IOGS-LEnsE-platforms/machine-vision/README.md

# Machine Vision Platform
Documentation of the pedagogic platform about Machine Vision used during labwors @ LEnsE / IOGS / France

Watch the complete documentation [here !!!](https://iogs-lense.github.io/machine-vision/)

## About Institut d'Optique and LEnsE
The **LEnsE**, ***Laboratoire d'Enseignement Expérimental***, [Website](http://lense.institutoptique.fr/)
