IOGS-LEnsE-platforms/machine-vision/docs/source/index.rst

.. Machine-Vision platform documentation master file, created by
   sphinx-quickstart on Sat Jan 13.
   You can adapt this file completely to your liking, but it should at least contain the root `toctree` directive.

Machine Vision platform's documentation
#######################################

.. caution::
   This documentation website is still in development

**Machine Vision** GitHub repository contains documentations of the pedagogic technical platform developed for Machine Vision labworks and projects of students.

The GitHub repository of this project : `Machine Vision <https://github.com/IOGS-LEnsE-platforms/machine-vision>`_

|

.. toctree::
   :maxdepth: 1
   :caption: Machine Vision
   
	Machine Vision platform<contents/machine_vision>

.. toctree::
   :maxdepth: 1
   :caption: Materials

	Overview<contents/material_overview>
	Electronic board<contents/material_board>
	Testing procedure<contents/material_testing>

.. toctree::
   :maxdepth: 1
   :caption: How To

.. toctree::
   :maxdepth: 1
   :caption: Contributors
   
	Main contributors<contents/main_contributors>
	Students contributions<contents/other_contributors>

Ressources
**********

Projects based on this platform require the following ressources :

* `Camera Interfaces <https://iogs-lense-ressources.github.io/camera-gui/>`_ to integrate camera vision for image processing.

Trainings
*********

Projects based on this platform require the following trainings :

* **Nucleo board basics** to control the conveyor, the lighting system, the sorter system and to get data from presence sensors for exemple.
* **Python GUI basics** to create a graphical user interface.
* **Python communication** to transmit data to a microcontroller (that controls the hardware part of the platform : conveyor, lights, sorter, sensors...).

About the LEnsE
***************

The **Experimental Teaching Laboratory** (*LEnsE*, for *Laboratoire d’ENSeignement Expérimental*) is a major structure of the *Institut d'Optique* engineering school. It offers remarkably strong training that contributes 25% of the total curriculum. It is an impressive structure where students have access to a large diversity of material and human resources to be able to gain the skills to become excellent experimenters recognized in their field.
