IOGS-LEnsE-platforms/machine-vision/documentation/brochages.pptx

Computer Vision / L476 board

Control of computer vision bench / Dobot conveyor

Functions

- Step Motor Control (x2)
  - Step Motor Driver – TMC2100
- RF data transmission
  - RN41/42 – Evaluation Board XV
- Position sensor SEN0239 (x3)
- Light control (x3 – R / G / B)

PROJECT VERSION

Based on Nucleo L476RG board

## Slide 2

Computer Vision / L476 board

Control of computer vision bench / Dobot conveyor

TX

PC_10

PC_12

Morpho Gauche / Nucléo

PC_11

PD_2

E5V

GPIO2_STATUS

RX

POUSS. 3

PC_9

PB_8

PB_9

Morpho Droit / Nucléo

PC_8

PC_6

PC_5

POUSS. 2

POUSS. 1

PA_13

GND

nRF24 / SCK

AVDD

GND

PA_5 / SCK

U5V

PA_12

PA_14

PA_15

5V

3.3V

nRF24 / MOSI

nRF24 / MISO

PA_6 / MISO

PA_7 / MOSI

D10 / CS

PA_11

PB_12

PB_11

LED 1

LED 2

RESET_N

GND

PB_7

PC_13

Vin

PA_0

GND

GND

nRF24 / CSN

nRF24 / CE

nRF24 / IRQ

PC_7

PA_9

PA_8

GND

PB_1

PB_2

MOT1_CFG3

CAPT 1

CAPT 2

PC_14

PC_15

MOT2_EN

MOT2_DIR

MOT2_STEP

PB_10

PB_4

PB_5

PB_13

PB_15

PB_14

MOT1_CFG2

MOT1_CFG1

MOT1_EN

Not Used

Digital Output

Digital Input

Analog Input

CAPT 3

ECLAIR 3

PH_0

PH_1

PC_2

A2

PA_1

PB_0

V_OUT_REF

MOT1_STEP

MOT1_DIR

D1

PA_10

PB_3

PC_4

AGND

MOT1_STEP*

ECLAIR 2

ECLAIR 1

Analog Output

PC_3

PC_0

PC_1

D0

* Must be set as input

## Slide 3

TMC2100 – Step Motor Driver

Step Motor Driver / Motor 1 / TMC2100

MBED6 Library : https://github.com/IOGS-LEnsE-embedded/MBED6_SupOpLibraries/tree/main/TMC2100

Nucleo Board

Not Used

Digital Output

Digital Input

Analog Input

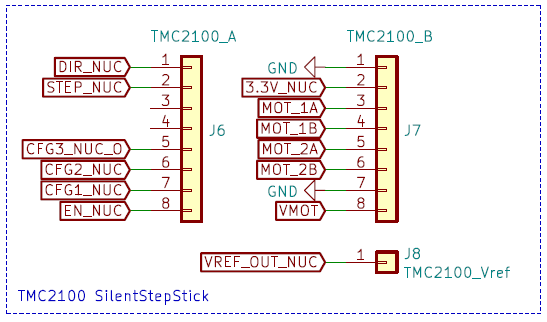
[picture p2: figure]

GND

TMC2100 / Motor1

PA_10

PB_3

MOT1_DIR

MOT1_STEP

3.3V

PB_1

MOT1_CFG3

PB_13

PB_15

PB_14

MOT1_CFG2

MOT1_CFG1

MOT1_EN

PC_4

PWM

MOT1_STEP

A2

V_OUT_REF

Analog Output

## Slide 4

nRF24 – RF transmission

nrF24L01 module for RF data transmission

MBED6 Library : https://github.com/IOGS-LEnsE-embedded/MBED6_SupOpLibraries/tree/main/nRF24

Nucleo Board

Not Used

Digital Output

Digital Input

Analog Input

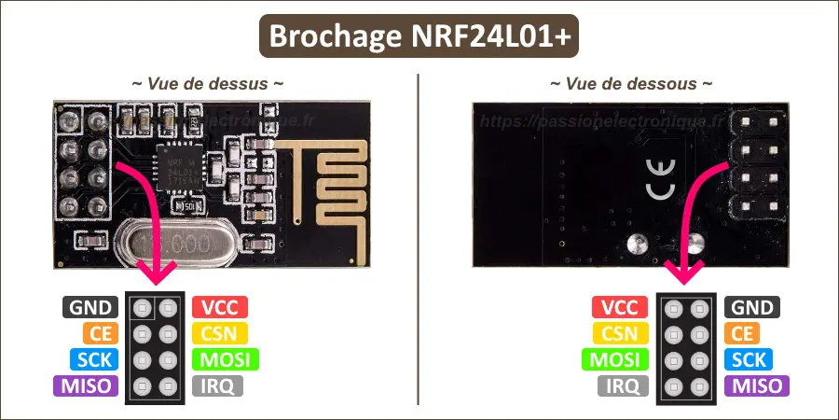
[picture p3: figure]

3.3V

GND

nRF24L01 / RF

PA_9

PA_8

PC_7

IRQ

CE

CSN

PA_6 / MISO

PA_7 / MOSI

PA_5/ SCK

SPI

MISO

MOSI

CLK

Analog Output
