IOGS-LEnsE-platforms/machine-vision/docs/source/contents/material_testing.rst

Machine Vision Testing procedures
#################################

Power supplies
**************

Lighting system
***************

Conveyor system
***************

Image acquisition
*****************
