IOGS-LEnsE-platforms/machine-vision/documentation/brochages.pdf

# Computer Vision / L476 board

# Control of computer vision bench / Dobot conveyor

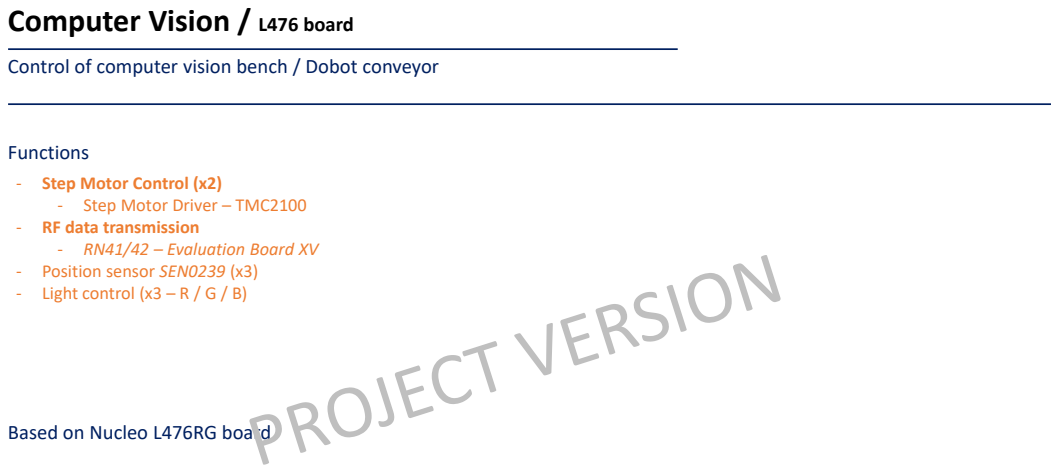
[picture p42: page 1]
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

Based on Nucleo L476RG board

# Computer Vision / L476 board

# Control of computer vision bench / Dobot conveyor

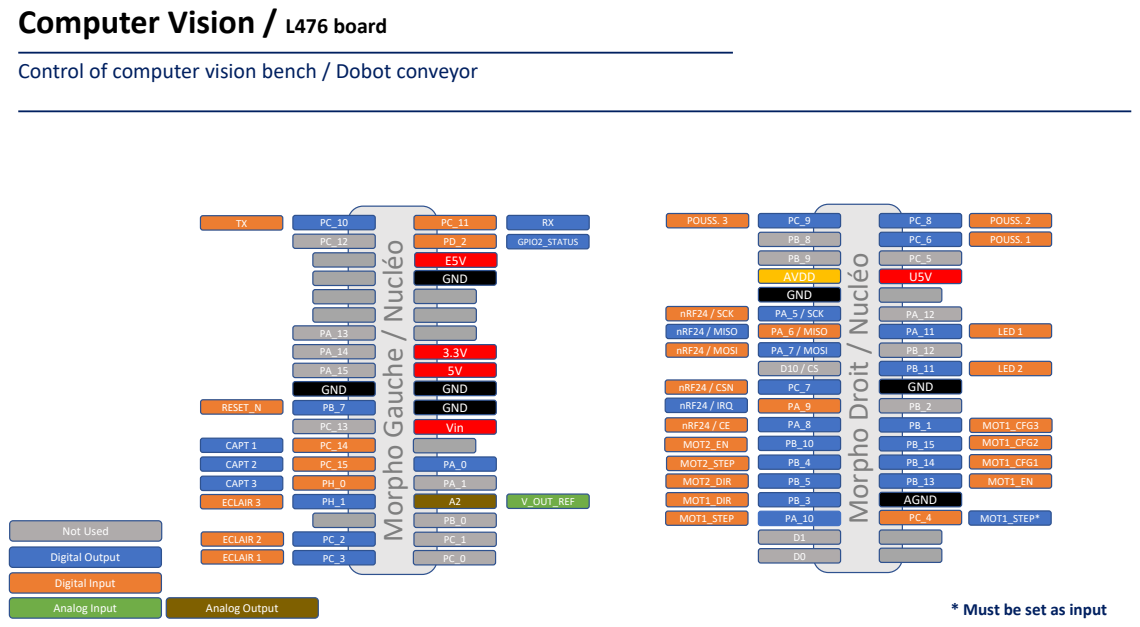
[picture p43: page 2]
Digital Output; Digital Input; Analog Input; PA_6 / MISO; PA_7 / MOSI; PA_5 / SCK; GND; AGND; AVDD; PD_2 E5V GND; GND Vin; RESET_N; GPIO2_STATUS; nRF24 / SCK; nRF24 / MISO; nRF24 / MOSI; nRF24 / IRQ; nRF24 / CSN; nRF24 / CE; Not Used; CAPT 1; CAPT 2; CAPT 3; ECLAIR 3; ECLAIR 2; ECLAIR 1; Analog Output; V_OUT_REF; POUSS. 3; POUSS. 2; POUSS. 1; LED 1; LED 2; MOT1_STEP; MOT1_DIR; MOT1_EN; MOT1_CFG1; MOT1_CFG2; MOT1_CFG3; MOT2_DIR; MOT2_STEP; MOT2_EN; MOT1_STEP*

Morpho Gauche / Nucléo

Morpho Droit / Nucléo

* Must be set as input

# TMC2100 – Step Motor Driver

# Step Motor Driver / Motor 1 / TMC2100 TMC2100 / Motor1

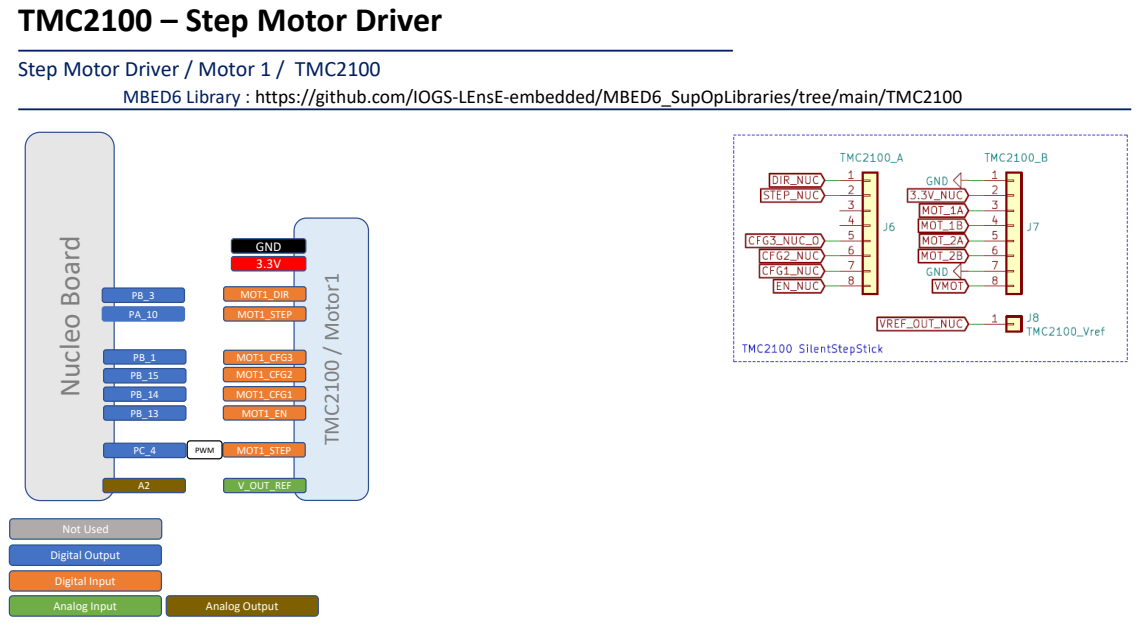
[picture p44: page 3]
Nucleo Board; GND 3.3V; MOT1_STEP; MOT1_DIR; MOT1_EN; MOT1_CFG1; MOT1_CFG2; MOT1_CFG3; PWM; V_OUT_REF; Digital Output; Digital Input; Not Used

MBED6 Library : https://github.com/IOGS-LEnsE-embedded/MBED6_SupOpLibraries/tree/main/TMC2100

# nRF24 – RF transmission

# nrF24L01 module for RF data transmission

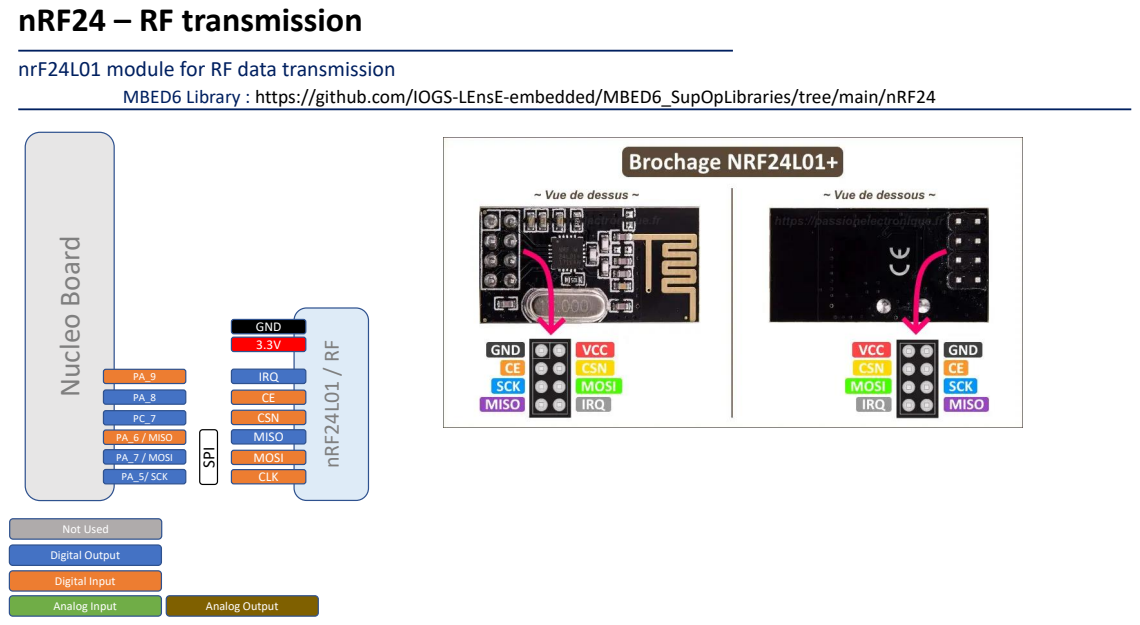
[picture p45: page 4]
Nucleo Board; PA_5/ SCK; nRF24L01 / RF; CLK; PA_7 / MOSI; MOSI; PA_6 / MISO; MISO SPI; CSN; IRQ; GND 3.3V; Digital Output; Digital Input; Not Used

MBED6 Library : https://github.com/IOGS-LEnsE-embedded/MBED6_SupOpLibraries/tree/main/nRF24
