IOGS-LEnsE-platforms/machine-vision/documentation/schematic.pdf

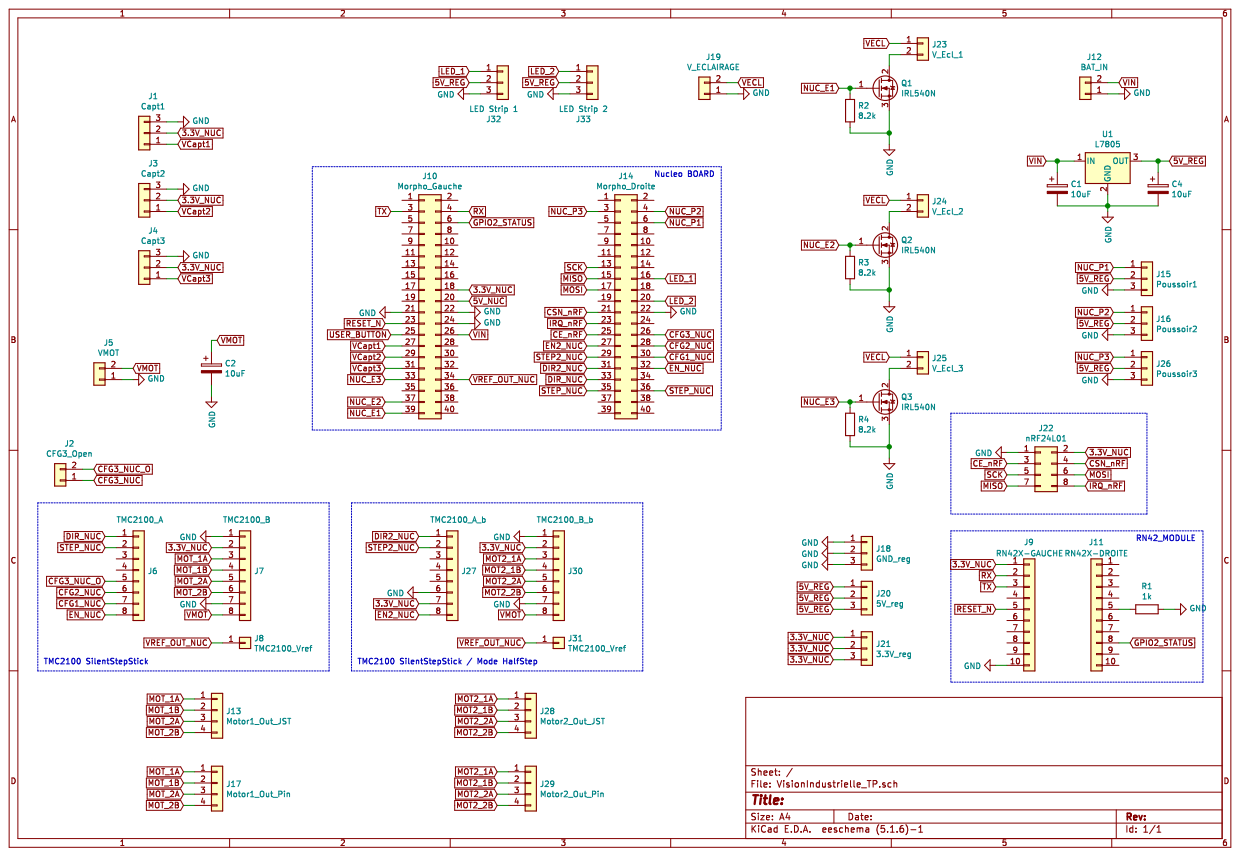
[picture p46: page 1]
