IOGS-LEnsE-platforms/machine-vision/documentation/PCB.pdf

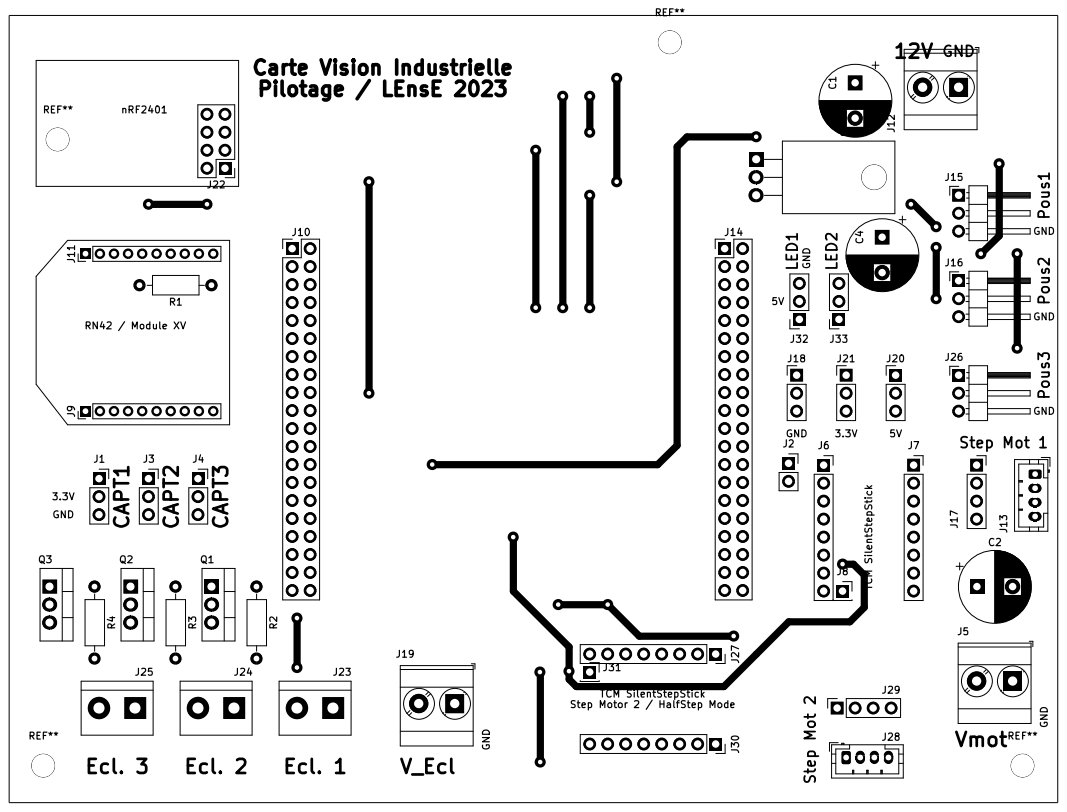
[picture p47: page 1]
