IOGS-LEnsE-platforms/machine-vision/elec_board/VisionIndustrielle_TP.kicad_pcb

## KiCad design elec_board/VisionIndustrielle_TP.kicad_pcb (2024-03-06)

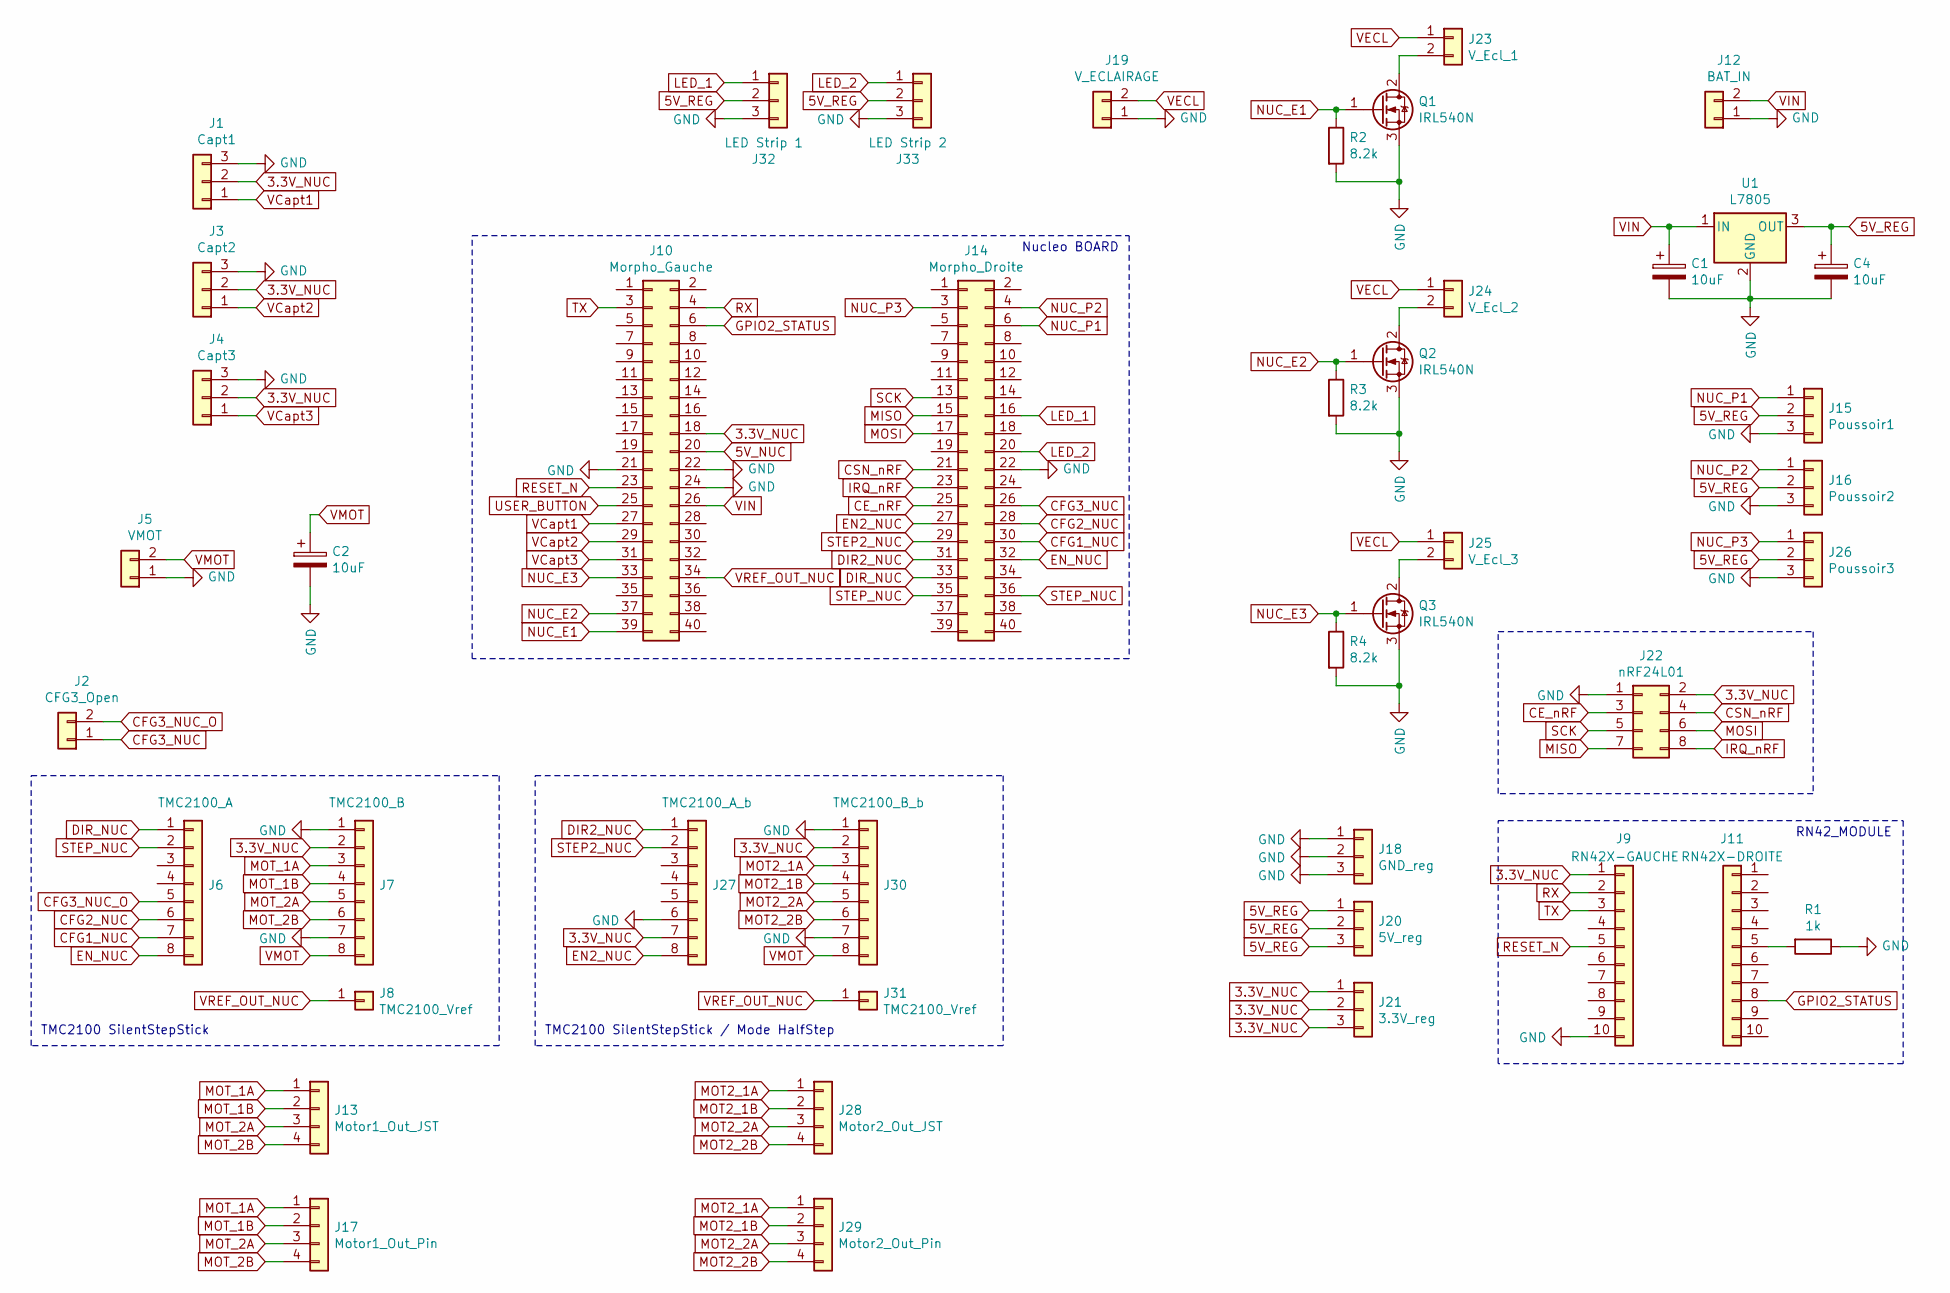
[picture p48: schematic VisionIndustrielle_TP.sch]

Parts:
C1, C2, C4: 10uF; CP_Radial_D10.0mm_P5.00mm
J1: Capt1; PinSocket_1x03_P2.54mm_Vertical
J2: CFG3_Open; PinSocket_1x02_P2.54mm_Vertical
J3: Capt2; PinSocket_1x03_P2.54mm_Vertical
J4: Capt3; PinSocket_1x03_P2.54mm_Vertical
J5: VMOT; TerminalBlock_Phoenix_MKDS-3-2-5.08_1x02_P5.08mm_Horizontal
J6: TMC2100_A; PinSocket_1x08_P2.54mm_Vertical
J7: TMC2100_B; PinSocket_1x08_P2.54mm_Vertical
J8, J31: TMC2100_Vref; PinSocket_1x01_P2.54mm_Vertical
J9: RN42X-GAUCHE; PinHeader_1x10_P2.00mm_Vertical
J10: Morpho_Gauche; PinHeader_2x20_P2.54mm_Vertical
J11: RN42X-DROITE; PinHeader_1x10_P2.00mm_Vertical
J12: BAT_IN; TerminalBlock_Phoenix_MKDS-3-2-5.08_1x02_P5.08mm_Horizontal
J13: Motor1_Out_JST; JST_PH_B4B-PH-K_1x04_P2.00mm_Vertical
J14: Morpho_Droite; PinHeader_2x20_P2.54mm_Vertical
J15: Poussoir1; PinHeader_1x03_P2.54mm_Horizontal
J16: Poussoir2; PinHeader_1x03_P2.54mm_Horizontal
J17: Motor1_Out_Pin; PinSocket_1x04_P2.54mm_Vertical
J18: GND_reg; PinHeader_1x03_P2.54mm_Vertical
J19: V_ECLAIRAGE; TerminalBlock_Phoenix_MKDS-3-2-5.08_1x02_P5.08mm_Horizontal
J20: 5V_reg; PinHeader_1x03_P2.54mm_Vertical
J21: 3.3V_reg; PinHeader_1x03_P2.54mm_Vertical
J22: nRF24L01; PinHeader_2x04_P2.54mm_Vertical
J23: V_Ecl_1; TerminalBlock_bornier-2_P5.08mm
J24: V_Ecl_2; TerminalBlock_bornier-2_P5.08mm
J25: V_Ecl_3; TerminalBlock_bornier-2_P5.08mm
J26: Poussoir3; PinHeader_1x03_P2.54mm_Horizontal
J27: TMC2100_A_b; PinSocket_1x08_P2.54mm_Vertical
J28: Motor2_Out_JST; JST_PH_B4B-PH-K_1x04_P2.00mm_Vertical
J29: Motor2_Out_Pin; PinSocket_1x04_P2.54mm_Vertical
J30: TMC2100_B_b; PinSocket_1x08_P2.54mm_Vertical
J32: LED Strip 1; PinSocket_1x03_P2.54mm_Vertical
J33: LED Strip 2; PinSocket_1x03_P2.54mm_Vertical
Q1, Q2, Q3: IRL540N; TO-220-3_Vertical
R1: 1k; R_Axial_DIN0207_L6.3mm_D2.5mm_P10.16mm_Horizontal
R2, R3, R4: 8.2k; R_Axial_DIN0207_L6.3mm_D2.5mm_P10.16mm_Horizontal
U1: L7805; TO-220-3_Horizontal_TabDown

Connections:
3.3V_NUC: J1.2, J3.2, J4.2, J7.2, J9.1, J10.18, J21.1, J21.2, J21.3, J22.2, J27.7, J30.2
5V_NUC: J10.20
5V_REG: C4.1, J15.2, J16.2, J20.1, J20.2, J20.3, J26.2, J32.2, J33.2, U1.3 (OUT)
CE_nRF: J14.25, J22.3
CFG1_NUC: J6.7, J14.30
CFG2_NUC: J6.6, J14.28
CFG3_NUC: J2.1, J14.26
CFG3_NUC_O: J2.2, J6.5
CSN_nRF: J14.21, J22.4
DIR2_NUC: J14.31, J27.1
DIR_NUC: J6.1, J14.33
EN2_NUC: J14.27, J27.8
EN_NUC: J6.8, J14.32
GND: C1.2, C2.2, C4.2, J1.3, J3.3, J4.3, J5.1, J7.1, J7.7, J9.10, J10.21, J10.22, J10.24, J12.1, J14.22, J15.3, J16.3, J18.1, J18.2, J18.3, J19.1, J22.1, J26.3, J27.6, J30.1, J30.7, J32.3, J33.3, Q1.3 (S), Q2.3 (S), Q3.3 (S), R1.1, R2.2, R3.2, R4.2, U1.2 (GND)
GPIO2_STATUS: J10.6, J11.8
IRQ_nRF: J14.23, J22.8
LED_1: J14.16, J32.1
LED_2: J14.20, J33.1
MISO: J14.15, J22.7
MOSI: J14.17, J22.6
MOT2_1A: J28.1, J29.1, J30.3
MOT2_1B: J28.2, J29.2, J30.4
MOT2_2A: J28.3, J29.3, J30.5
MOT2_2B: J28.4, J29.4, J30.6
MOT_1A: J7.3, J13.1, J17.1
MOT_1B: J7.4, J13.2, J17.2
MOT_2A: J7.5, J13.3, J17.3
MOT_2B: J7.6, J13.4, J17.4
NUC_E1: J10.39, Q1.1 (G), R2.1
NUC_E2: J10.37, Q2.1 (G), R3.1
NUC_E3: J10.33, Q3.1 (G), R4.1
NUC_P1: J14.6, J15.1
NUC_P2: J14.4, J16.1
NUC_P3: J14.3, J26.1
unnamed: J11.5, R1.2
unnamed: J23.2, Q1.2 (D)
unnamed: J24.2, Q2.2 (D)
unnamed: J25.2, Q3.2 (D)
RESET_N: J9.5, J10.23
RX: J9.2, J10.4
SCK: J14.13, J22.5
STEP2_NUC: J14.29, J27.2
STEP_NUC: J6.2, J14.35, J14.36
TX: J9.3, J10.3
USER_BUTTON: J10.25
VCapt1: J1.1, J10.27
VCapt2: J3.1, J10.29
VCapt3: J4.1, J10.31
VECL: J19.2, J23.1, J24.1, J25.1
VIN: C1.1, J10.26, J12.2, U1.1 (IN)
VMOT: C2.1, J5.2, J7.8, J30.8
VREF_OUT_NUC: J8.1, J10.34, J31.1

Notes on the sheet:
RN42_MODULE
Nucleo BOARD
TMC2100 SilentStepStick
TMC2100 SilentStepStick / Mode HalfStep

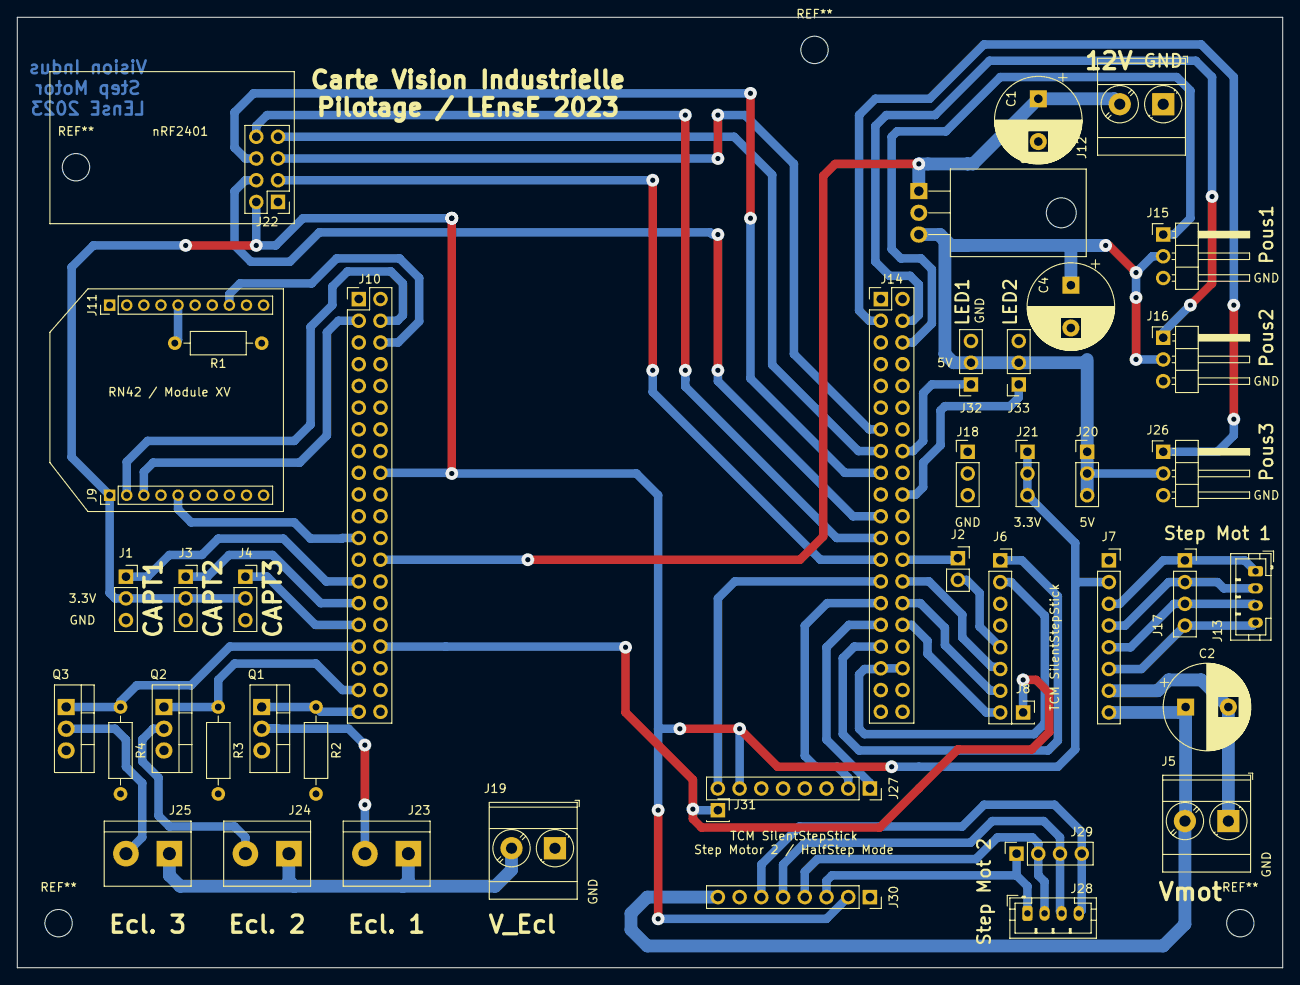
[picture p49: board VisionIndustrielle_TP.kicad_pcb from above]

Board: 2 copper layers, 148.0 x 111.1 mm, 44 parts (0 on the bottom side), 50 nets.
