IOGS-LEnsE-platforms/machine-vision/(commit log)

2024-03-06 First Update - Move from LEnsE organization
    [VisionIndustrielle_TP-B_Cu.gbr, VisionIndustrielle_TP-B_Mask.gbr, VisionIndustrielle_TP-B_Paste.gbr, VisionIndustrielle_TP-B_SilkS.gbr, VisionIndustrielle_TP-Edge_Cuts.gbr, VisionIndustrielle_TP-F_Cu.gbr, VisionIndustrielle_TP-F_Mask.gbr, VisionIndustrielle_TP-F_Paste.gbr]
2024-03-06 Update Documentation / Material overview
2024-05-06 Adding PIMS 2022 program
    [Circle0.csv, Circle1.csv, Circle2.csv, Hexagon0.csv, Hexagon1.csv, Hexagon2.csv, Hexagon3.csv, Pentagon0.csv]
